samarthamp/Two-Channel-Signal-Generator/FUNGENE Spec-Sheet.xlsx

Wave | Vpp | Max Freq | Min Freq | Max Baud | Speed | Permanent /Temporary
Sine | 0.55-0.65 | 3MHz | 1Hz |  |  | P
Square | 5 | 3MHz | 1Hz |  |  | P
Triangle | 0.55-0.65 | 3MHz | 1Hz |  |  | P
BFSK | 0.55-0.65 | 3MHz | 1Hz | 25000 | 25Kbps | P
BPSK | 0.55-0.65 | 3MHz | 1Hz | 25000 | 25Kbps | P
BFPSK | 0.55-0.65 | 3MHz | 1Hz | 25000 | 25Kbps | P
QFSK | 0.55-0.65 | 3MHz | 1Hz | 8000 | 16Kbps | P
QPSK | 0.55-0.65 | 3MHz | 1Hz | 8000 | 16Kbps | P
ASK | 0 & 0.55-0.65 | 3MHz | 1Hz | 25000 | 25Kbps | P
Sweep | 0.55-0.65 | 3MHz | 1Hz |  |  | P
PWM | 3.6 | 5MHz | 1Hz | 200000 |  | P
3 BIT FM | 0.55-0.65 | 3MHz | 1Hz | 8000 | 24Kbps | P
4 BIT FM | 0.55-0.65 | 3MHZ | 1Hz | 8000 | 32Kbps | P
5 BIT FM | 0.55-0.65 | 3MHz | 1Hz | 8000 | 40Kbps | P
6 BIT FM | 0.55-0.65 | 3MHZ | 1Hz | 8000 | 48Kbps | P
7 BIT FM | 0.55-0.65 | 3MHz | 1Hz | 8000 | 56Kbps | P
8 BIT FM | 0.55-0.65 | 3MHZ | 1Hz | 8000 | 64Kbps | P
3 BIT PSK | 0.55-0.65 | 3MHz | 1Hz | 8000 | 24Kbps | P
4 BIT PSK | 0.55-0.65 | 3MHZ | 1Hz | 8000 | 24Kbps | P
FM |  |  |  |  |  | T
AM |  |  |  |  |  | T
RAMP |  |  |  |  |  | T
