samarthamp/Two-Channel-Signal-Generator/(commit log)

2025-07-10 Added FUNGENE and Phase_Loop Arduino files
2025-07-10 Added spec sheet
    [FUNGENE Spec-Sheet.xlsx]
